JoelHutton/Dissertation/Documents/dissertation/Dissertation/20161130_161854.jpg

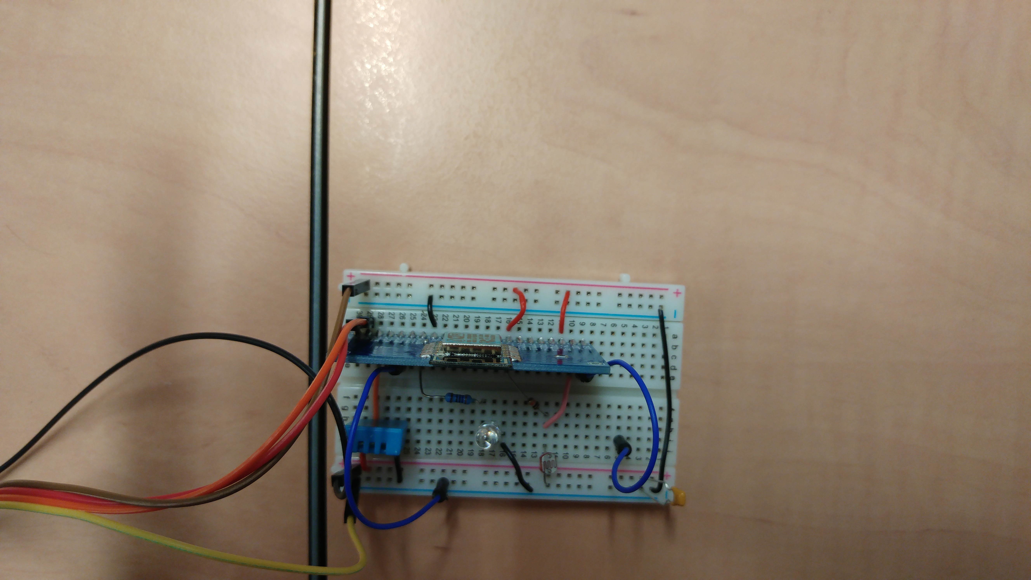
Documents/dissertation/Dissertation/20161130_161854.jpg
