JoelHutton/Dissertation/Documents/dissertation/Dissertation/20161230_181645.jpg

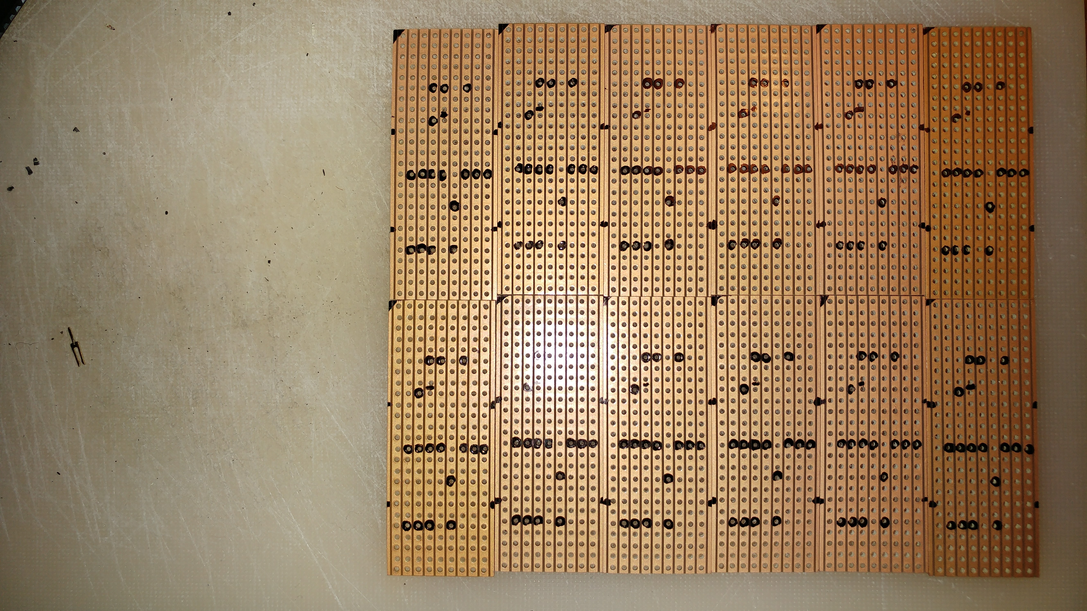
Documents/dissertation/Dissertation/20161230_181645.jpg
