JoelHutton/Dissertation/Documents/dissertation/Dissertation/20161130_171213.jpg

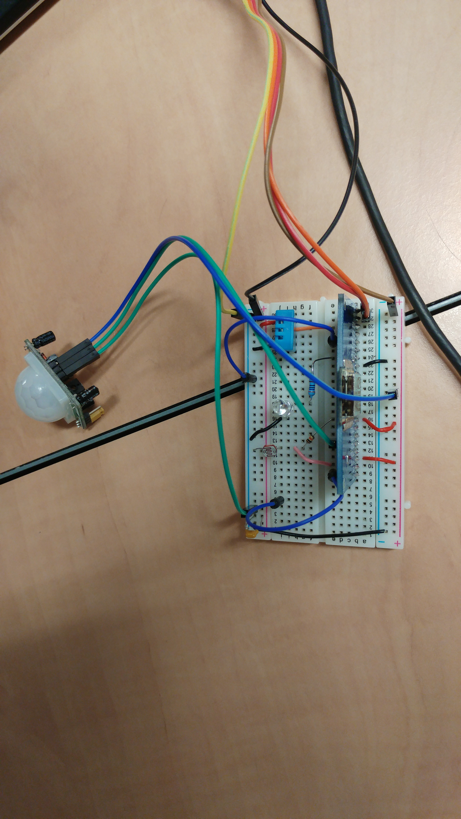
Documents/dissertation/Dissertation/20161130_171213.jpg
