JoelHutton/Dissertation/Documents/dissertation/Dissertation/20161230_142931.jpg

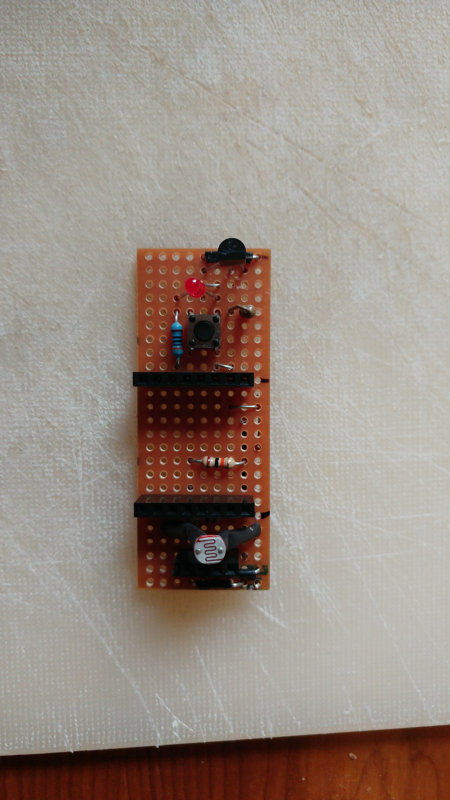
Documents/dissertation/Dissertation/20161230_142931.jpg
