JoelHutton/Dissertation/Documents/dissertation/Dissertation/20161230_142938.jpg

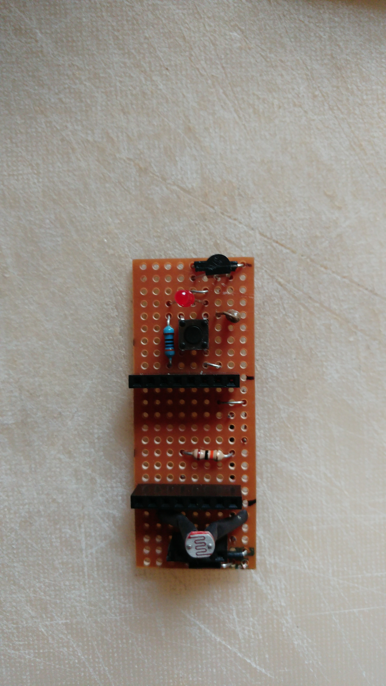
Documents/dissertation/Dissertation/20161230_142938.jpg
