JoelHutton/Dissertation/Documents/dissertation/Dissertation/20161230_142949.jpg

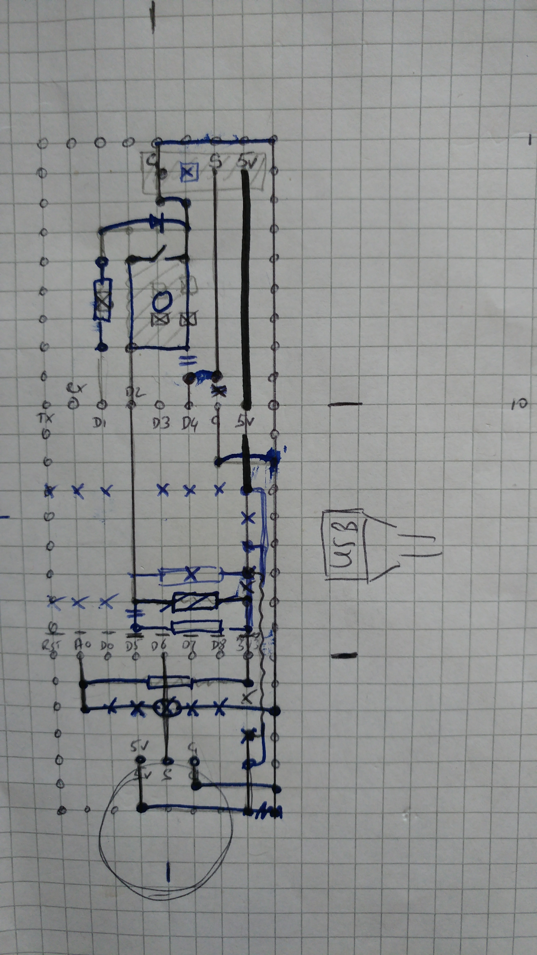
Documents/dissertation/Dissertation/20161230_142949.jpg
