JoelHutton/Dissertation/Documents/dissertation/Dissertation/20161230_145643.jpg

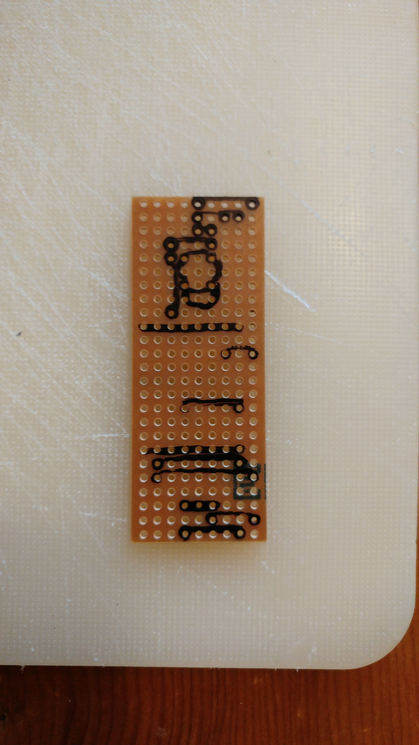
Documents/dissertation/Dissertation/20161230_145643.jpg
