JoelHutton/Dissertation/Documents/dissertation/Dissertation/20161230_145652.jpg

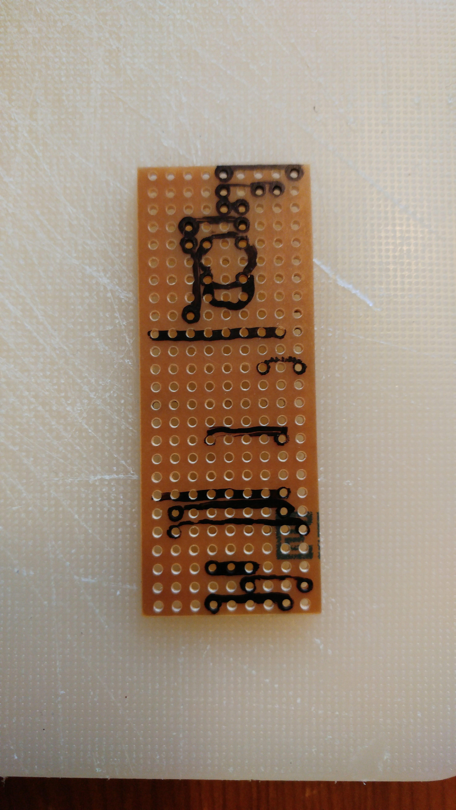
Documents/dissertation/Dissertation/20161230_145652.jpg
