JoelHutton/Dissertation/Documents/dissertation/Dissertation/20161230_150851.jpg

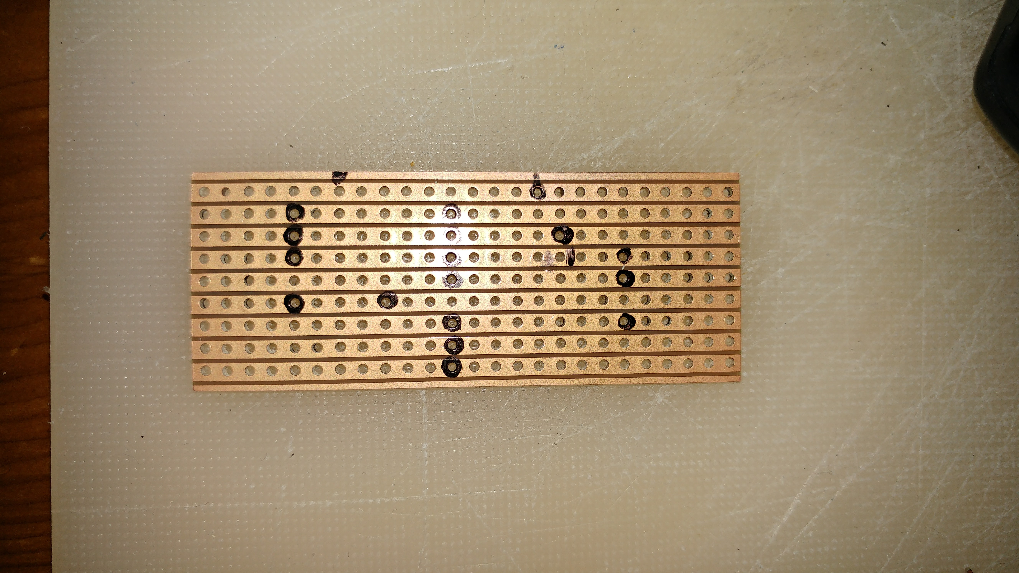
Documents/dissertation/Dissertation/20161230_150851.jpg
