JoelHutton/Dissertation/Documents/dissertation/Dissertation/20161230_175132.jpg

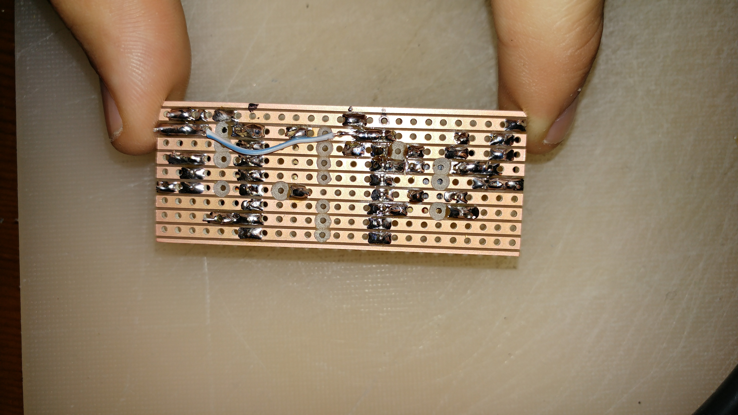
Documents/dissertation/Dissertation/20161230_175132.jpg
