JoelHutton/Dissertation/Documents/dissertation/Dissertation/20161230_175625.jpg

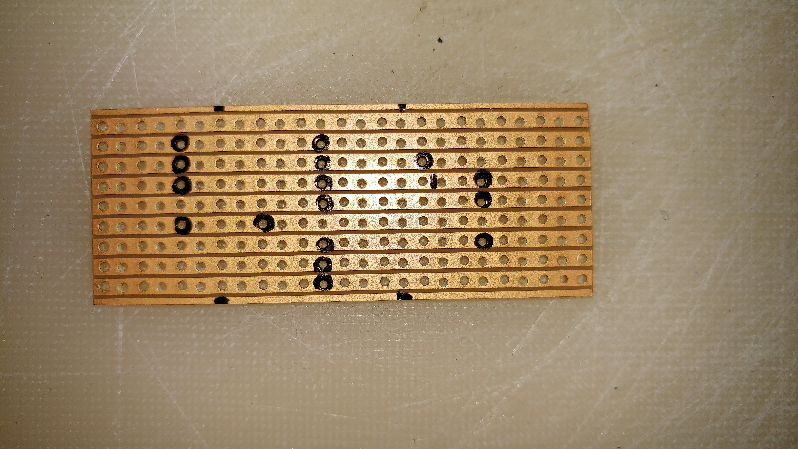
Documents/dissertation/Dissertation/20161230_175625.jpg
