JoelHutton/Dissertation/Documents/dissertation/Dissertation/20161230_150858.jpg

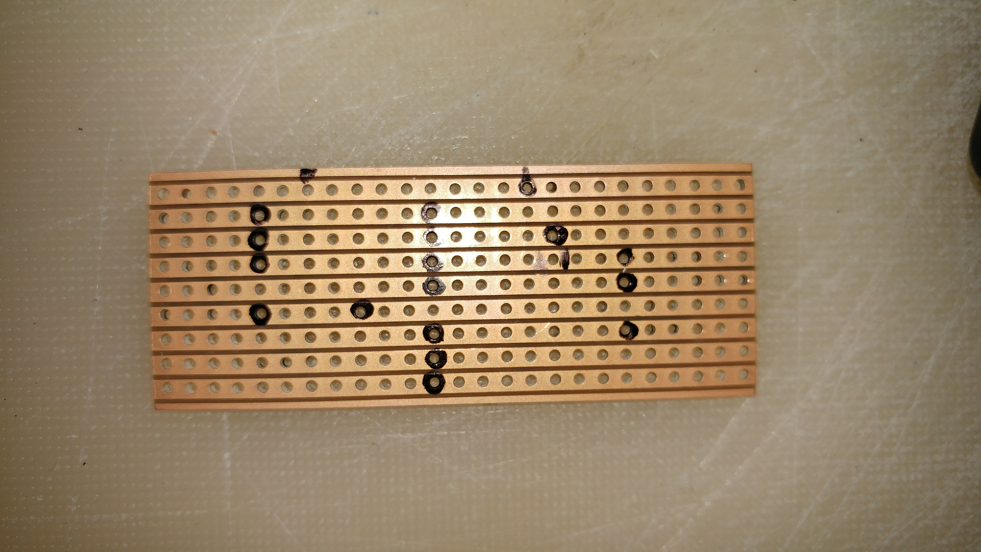
[picture p3: Documents/interim_report/Dissertation/20161230_150858.jpg]
Documents/dissertation/Dissertation/20161230_150858.jpg
