JoelHutton/Dissertation/Documents/dissertation/Dissertation/20161230_151405.jpg

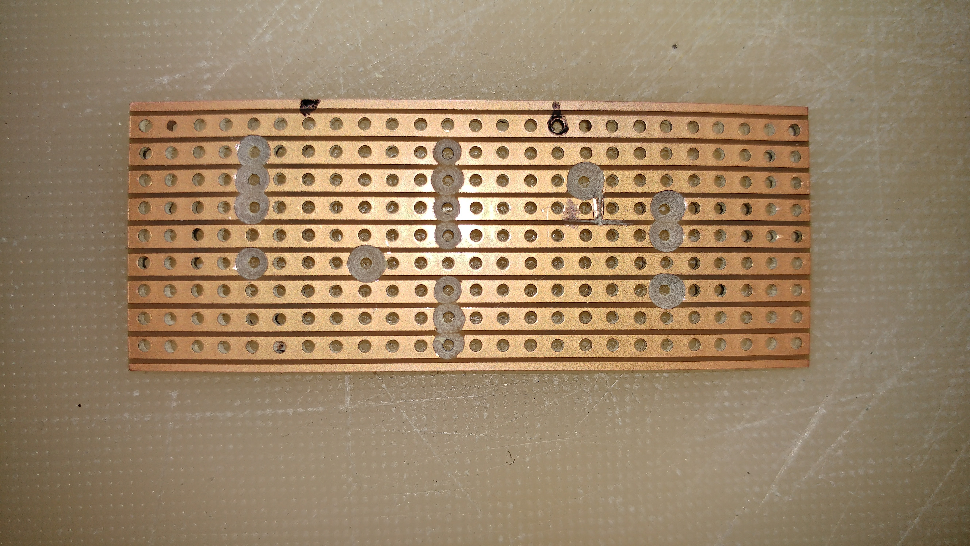
[picture p4: Documents/interim_report/Dissertation/20161230_151405.jpg]
Documents/dissertation/Dissertation/20161230_151405.jpg
